emeb/f373_seq2/README.md

# f373_seq2
3-channel CV + Gate step sequencer for Eurorack based on the STM32F373CCT6 processor.

For more information, please see the website http://ebrombaugh.studionebula.com/synth/f373_seq2/index.html
