emeb/f373_seq2/hardware/README.md

# f373_seq2 hardware
Hardware Design materials for a 3-channel CV + Gate step sequencer for
Eurorack based on the STM32F373CCT6 processor.
