emeb/f373_seq2/documents/README.md

# f373_seq2 documentation
Documents for a3-channel CV + Gate step sequencer for Eurorack based on the
STM32F373CCT6 processor.

Included here are

* Schematics in PDF format for the panel and backboard.

* Images of the top and bottom layers of both boards for reference.

* Bill of Materials (BOM) for both boards in spreadsheet and PDF format.
