emeb/f373_seq2/hardware/diptrace/README.md

# f373_seq2 diptrace files
Schematic and layout files for a 3-channel CV + Gate step sequencer for
Eurorack based on the STM32F373CCT6 processor.

These files require the Diptrace PCB design tools. The design is 2-layer only
and may be usable with the free demo version of the tools.
