emeb/f373_seq2/hardware/STM32CubeMX/README.md

# f373_seq2 STM32CubeMX files
CubeMX files for a 3-channel CV + Gate step sequencer for Eurorack
based on the STM32F373CCT6 processor.

This is a project file for the CubeMX processor configuration tool available
from ST.com
