emeb/f373_seq2/documents/f373_seq2_back_bottom.png

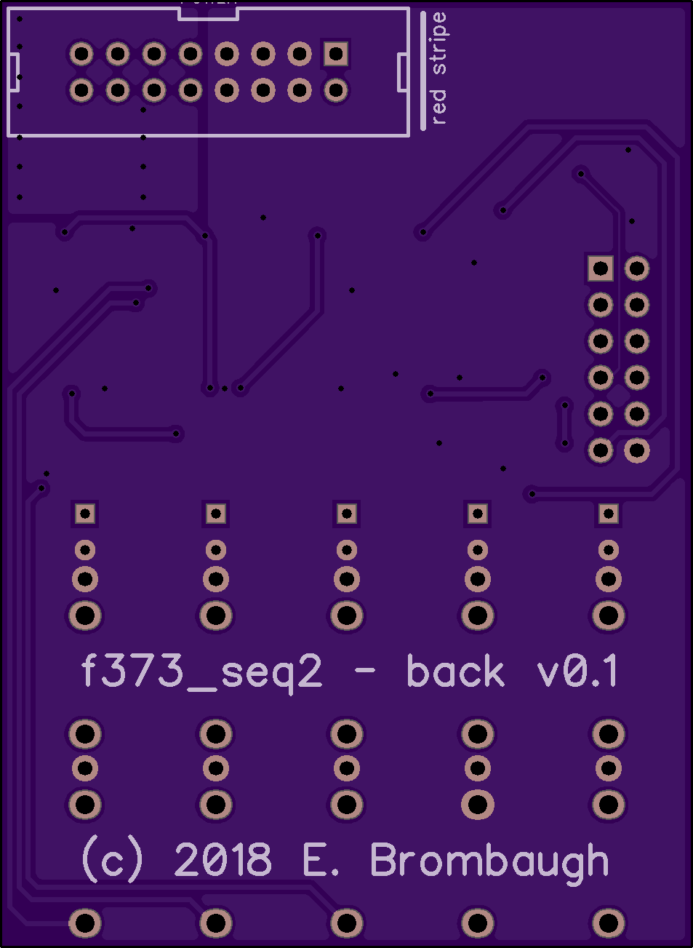
documents/f373_seq2_back_bottom.png
