emeb/f373_seq2/documents/f373_seq2_back_top.png

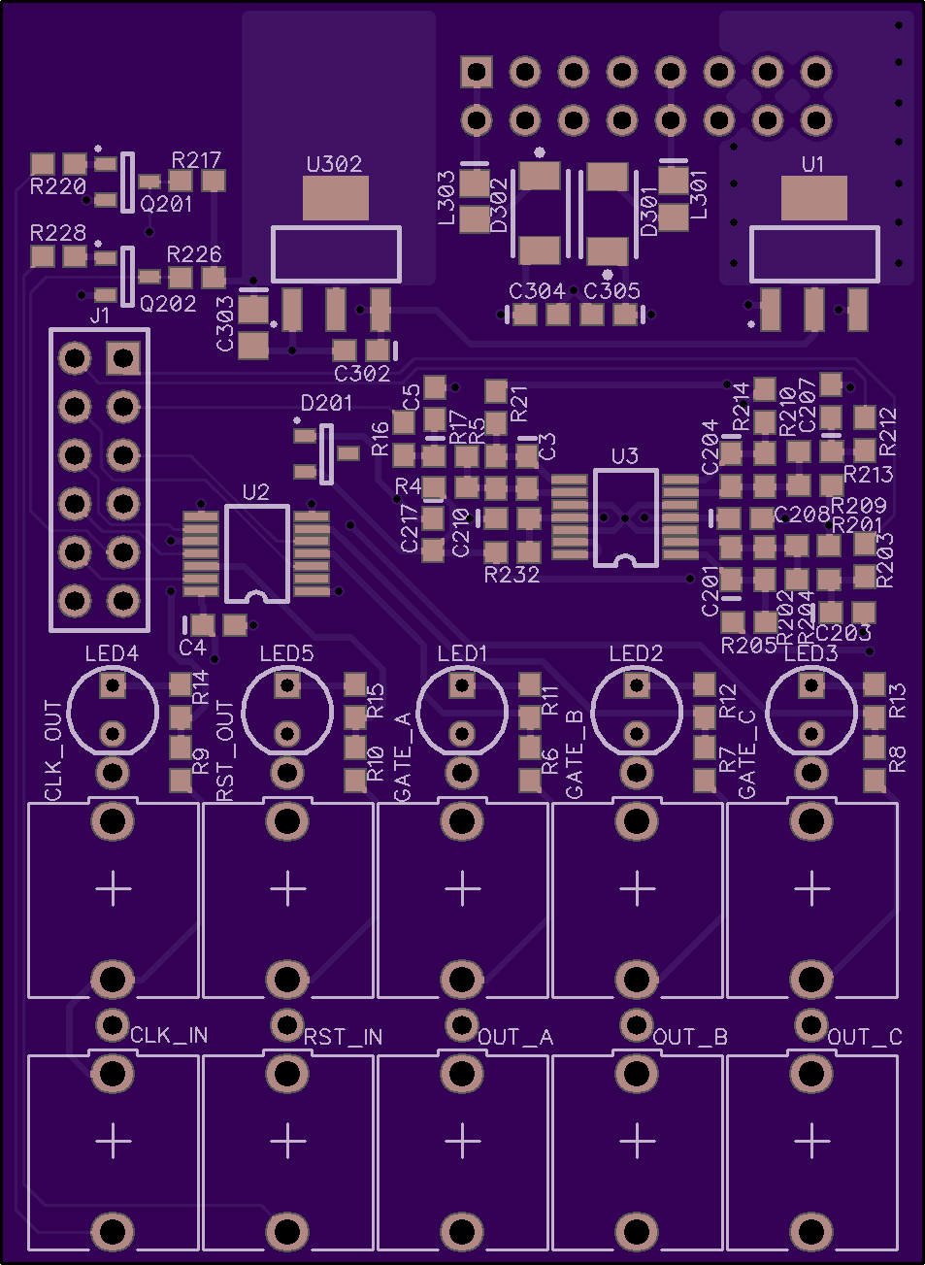
documents/f373_seq2_back_top.png
