emeb/f373_seq2/documents/f373_seq2_panel_top.png

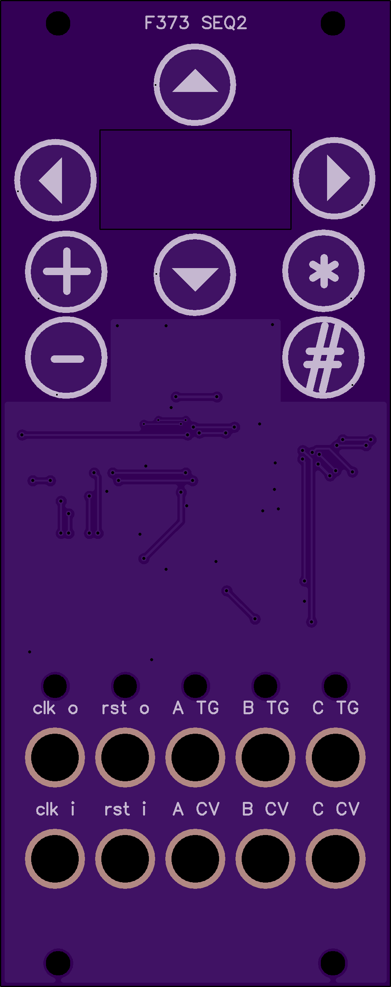
documents/f373_seq2_panel_top.png
