emeb/f373_seq2/(list of files, drawings)

Other design files:
hardware/diptrace/f373_seq2.dch
hardware/diptrace/f373_seq2.dip
hardware/diptrace/f373_seq2_back.dch
hardware/diptrace/f373_seq2_back.dip
