emeb/f373_seq2/hardware/STM32CubeMX/f373_seq2.ioc

Mcu.UserName=STM32F373CCTx
PA0.Signal=TSC_G1_IO1
PA1.Signal=TSC_G1_IO2
PA10.Signal=USART1_RX
PA11.Signal=S_TIM4_CH1
PA12.Signal=SPI1_SCK
PA13.Signal=SYS_JTMS-SWDIO
PA14.Signal=SYS_JTCK-SWCLK
PA15.Signal=S_TIM2_CH1_ETR
PA2.Signal=TSC_G1_IO3
PA3.Signal=TSC_G1_IO4
PA4.Signal=COMP_DAC11_group
PA5.Signal=COMP_DAC12_group
PA6.Signal=COMP_DAC21_group
PA8.Signal=S_TIM5_CH1_ETR
PA9.Signal=USART1_TX
PB0.Signal=ADC1_IN8
PB1.Signal=ADC1_IN9
PB14.Signal=TSC_G6_IO1
PB15.Signal=TSC_G6_IO2
PB2.GPIO_Label=OLED_NRST
PB2.Signal=GPIO_Output
PB3.Signal=TSC_G5_IO1
PB4.Signal=TSC_G5_IO2
PB5.Signal=S_TIM3_CH2
PB6.Signal=TSC_G5_IO3
PB7.Signal=TSC_G5_IO4
PB8.Signal=I2C1_SCL
PB9.Signal=I2C1_SDA
PC13.Signal=GPXTI13
PC14-OSC32_IN.Signal=GPXTI14
PD8.Signal=TSC_G6_IO3
PE8.GPIO_Label=OLED_DC
PE8.Signal=GPIO_Output
PE9.GPIO_Label=OLED_CS
PE9.Signal=GPIO_Output
PF0-OSC_IN.Signal=RCC_OSC_IN
PF1-OSC_OUT.Signal=RCC_OSC_OUT
PF6.Signal=SPI1_MOSI
