emeb/f373_seq2/software/arial_24_bold_32_numpunct.c

/*============================================================================*/
/* Font name: arial_24_bold_32_numpunct                                       */
/* Characters: 16                                                             */
/* Maximal character x-size: 17                                               */
/* Characters y-size: 32                                                      */
/*============================================================================*/

#include "arial_24_bold_32_numpunct.h"

/*============================================*/
/*========= Character pointers table =========*/
/*============================================*/

TCLISTP arial_24_bold_32_numpunct[256]=
	{arial_24_bold_32_numpunct_blank,
	 arial_24_bold_32_numpunct_blank,
	 arial_24_bold_32_numpunct_blank,
	 arial_24_bold_32_numpunct_blank,
	 arial_24_bold_32_numpunct_blank,
	 arial_24_bold_32_numpunct_blank,
	 arial_24_bold_32_numpunct_blank,
	 arial_24_bold_32_numpunct_blank,
	 arial_24_bold_32_numpunct_blank,
	 arial_24_bold_32_numpunct_blank,
	 arial_24_bold_32_numpunct_blank,
	 arial_24_bold_32_numpunct_blank,
	 arial_24_bold_32_numpunct_blank,
	 arial_24_bold_32_numpunct_blank,
	 arial_24_bold_32_numpunct_blank,
	 arial_24_bold_32_numpunct_blank,
	 arial_24_bold_32_numpunct_blank,
	 arial_24_bold_32_numpunct_blank,
	 arial_24_bold_32_numpunct_blank,
	 arial_24_bold_32_numpunct_blank,
	 arial_24_bold_32_numpunct_blank,
	 arial_24_bold_32_numpunct_blank,
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
	b2b(0,0,0,0,0,0,0,0),b2b(0,0,0,0,0,0,0,0),b2b(0,0,0,0,0,0,0,0),b2b(0,0,0,0,0,0,0,0),
	b2b(0,0,0,0,0,0,0,0),b2b(0,0,0,0,0,0,0,0),b2b(0,0,0,0,0,0,0,0),b2b(0,0,0,0,0,0,0,0),
	b2b(0,0,0,0,0,0,0,0),b2b(0,0,0,0,0,0,0,0),b2b(0,0,0,0,0,0,0,0),b2b(0,0,0,0,0,0,0,0)};
